ruffner/kiln_controller/(commit log)

2025-05-04 initial commit. working PID control for one TC and all elements controlled as a group.
2025-05-04 add groundstation firmware
